klaus-liebler/whsplc01/pcb/V001/strapping.PNG

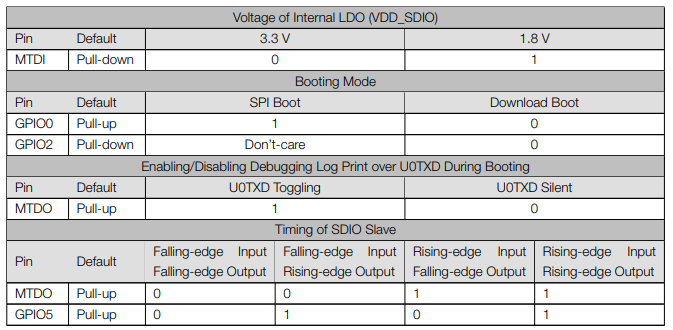
pcb/V001/strapping.PNG
