klaus-liebler/whsplc01/pcb/V001/V001.kicad_pcb

## KiCad design pcb/V001/V001.kicad_pcb (2020-04-13)

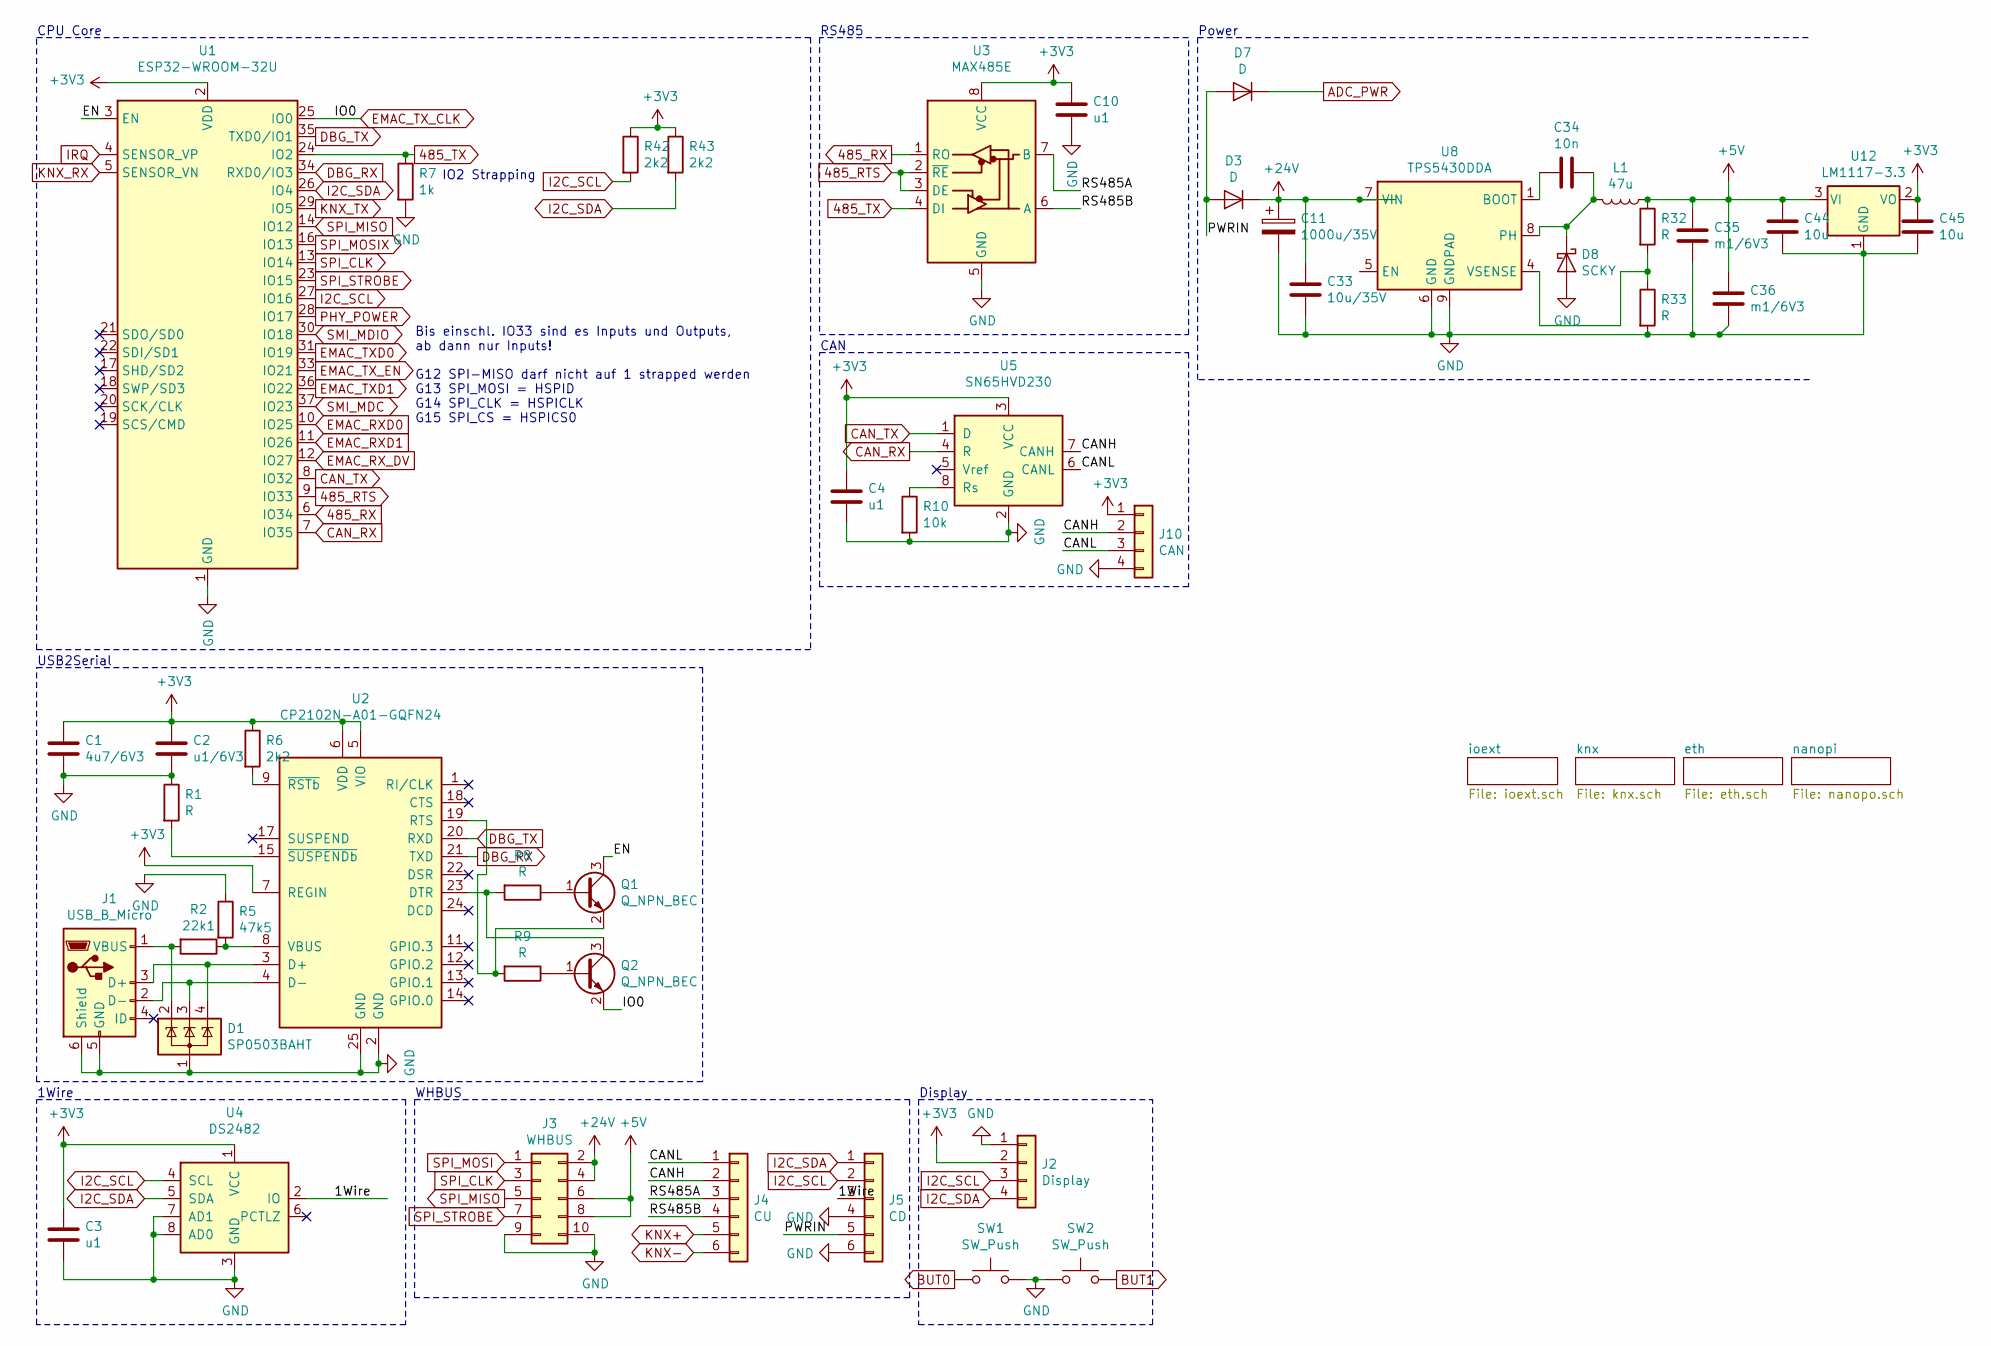
[picture p2: schematic V001.sch]

Parts:
C1: 4u7/6V3; C_0805_2012Metric
C2: u1/6V3; C_0603_1608Metric
C3, C4, C10: u1; C_0603_1608Metric
C11: 1000u/35V; CP_Radial_D10.0mm_P5.00mm_laydown
C33: 10u/35V; C_1210_3225Metric
C34: 10n; C_0603_1608Metric
C35, C36: m1/6V3; C_1206_3216Metric
C44, C45: 10u; C_0805_2012Metric
D1: SP0503BAHT; SOT-143
D3, D7: D; D_SOD-123
D8: SCKY; D_SMA
J1: USB_B_Micro; USB_Micro-B_Molex-105017-0001
J2: Display; PinHeader_1x04_P2.54mm_Vertical
J3: WHBUS; IDC-Header_2x05_P2.54mm_Vertical
J4: CU; Wago_734-136_1x06_P3.50mm_Vertical
J5: CD; Wago_734-136_1x06_P3.50mm_Vertical
J10: CAN; PinHeader_1x04_P2.54mm_Horizontal
L1: 47u; L_Wuerth_WE-PD-Typ-M-Typ-S_Handsoldering
Q1, Q2: Q_NPN_BEC; SOT-23
R1, R8, R9, R32, R33: R; R_0603_1608Metric
R2: 22k1; R_0603_1608Metric
R5: 47k5; R_0603_1608Metric
R6, R42, R43: 2k2; R_0603_1608Metric
R7: 1k; R_0603_1608Metric
R10: 10k; R_0603_1608Metric
SW1, SW2: SW_Push; SW_Tactile_SPST_Angled_PTS645Vx83-2LFS
U1: ESP32-WROOM-32U
U2: CP2102N-A01-GQFN24; QFN-24-1EP_4x4mm_P0.5mm_EP2.6x2.6mm
U3: MAX485E; SOIC-8_3.9x4.9mm_P1.27mm
U4: DS2482; SOIC-8_3.9x4.9mm_P1.27mm
U5: SN65HVD230; SOIC-8_3.9x4.9mm_P1.27mm
U8: TPS5430DDA; TI_SO-PowerPAD-8_ThermalVias
U12: LM1117-3.3; SOT-223-3_TabPin2

Connections:
485_RTS: U1.9 (IO33), U3.2 (~RE), U3.3 (DE)
485_RX: U1.6 (IO34), U3.1 (RO)
485_TX: R7.1, U1.24 (IO2), U3.4 (DI)
+3V3: C1.1, C2.1, C3.1, C4.1, C10.1, C45.1, J2.2, J10.1, R6.1, R42.1, R43.1, U1.2 (VDD), U2.5 (VIO), U2.6 (VDD), U2.7 (REGIN), U3.8 (VCC), U4.1 (VCC), U5.3 (VCC), U12.2 (VO); also elsewhere on the board
+5V: C35.1, C36.1, C44.1, J3.6, J3.8, L1.1, R32.1, U12.3 (VI); also elsewhere on the board
+24V: C11.1, C33.1, D3.1 (K), J3.2, J3.4, U8.7 (VIN)
/1Wire: J5.3, U4.2 (IO)
/CANH: J4.2, J10.2, U5.7 (CANH)
/CANL: J4.1, J10.3, U5.6 (CANL)
/EN: Q1.3 (C), U1.3 (EN)
/PWRIN: D3.2 (A), D7.2 (A), J5.5
/RS485A: J4.3, U3.7 (B)
/RS485B: J4.4, U3.6 (A)
ADC_PWR: D7.1 (K); also elsewhere on the board
BUT0: SW1.1; also elsewhere on the board
BUT1: SW2.2; also elsewhere on the board
CAN_RX: U1.7 (IO35), U5.4 (R)
CAN_TX: U1.8 (IO32), U5.1 (D)
DBG_RX: U1.34 (RXD0/IO3), U2.21 (TXD); also elsewhere on the board
DBG_TX: U1.35 (TXD0/IO1), U2.20 (RXD); also elsewhere on the board
EMAC_RXD0: U1.10 (IO25); also elsewhere on the board
EMAC_RXD1: U1.11 (IO26); also elsewhere on the board
EMAC_RX_DV: U1.12 (IO27); also elsewhere on the board
EMAC_TXD0: U1.31 (IO19); also elsewhere on the board
EMAC_TXD1: U1.36 (IO22); also elsewhere on the board
EMAC_TX_CLK: Q2.2 (E), U1.25 (IO0); also elsewhere on the board
EMAC_TX_EN: U1.33 (IO21); also elsewhere on the board
GND: C1.2, C2.2, C3.2, C4.2, C10.2, C11.2, C33.2, C35.2, C36.2, C44.2, C45.2, D1.1 (A), D8.2 (A), J1.5 (GND), J1.6 (Shield), J2.1, J3.9, J3.10, J5.4, J5.6, J10.4, R1.1, R5.1, R7.2, R10.2, R33.2, SW1.2, SW2.1, U1.1 (GND), U1.15 (GND), U1.38 (GND), U2.2 (GND), U2.25 (GND), U3.5 (GND), U4.3 (GND), U4.7 (AD1), U4.8 (AD0), U5.2 (GND), U8.6 (GND), U8.9 (GNDPAD), U12.1 (GND); also elsewhere on the board
I2C_SCL: J2.3, J5.2, R42.2, U1.27 (IO16), U4.4 (SCL)
I2C_SDA: J2.4, J5.1, R43.2, U1.26 (IO4), U4.5 (SDA)
KNX+: J4.5; also elsewhere on the board
KNX-: J4.6; also elsewhere on the board
KNX_RX: U1.5 (SENSOR_VN); also elsewhere on the board
KNX_TX: U1.29 (IO5); also elsewhere on the board
unnamed: C34.1, D8.1 (K), L1.2, U8.8 (PH)
unnamed: C34.2, U8.1 (BOOT)
unnamed: D1.2 (K), J1.1 (VBUS), R2.2
unnamed: D1.3 (K), J1.2 (D-), U2.4 (D-)
unnamed: D1.4 (K), J1.3 (D+), U2.3 (D+)
unnamed: Q1.1 (B), R8.1
unnamed: Q1.2 (E), R9.2, U2.19 (RTS)
unnamed: Q2.1 (B), R9.1
unnamed: Q2.3 (C), R8.2, U2.23 (DTR)
unnamed: R1.2, U2.15 (~SUSPENDb)
unnamed: R2.1, R5.2, U2.8 (VBUS)
unnamed: R6.2, U2.9 (~RSTb)
unnamed: R10.1, U5.8 (Rs)
unnamed: R32.2, R33.1, U8.4 (VSENSE)
PHY_POWER: U1.28 (IO17); also elsewhere on the board
SMI_MDC: U1.37 (IO23); also elsewhere on the board
SMI_MDIO: U1.30 (IO18); also elsewhere on the board
SPI_CLK: J3.3, U1.13 (IO14); also elsewhere on the board
SPI_MISO: J3.5, U1.14 (IO12)
SPI_MOSI: J3.1; also elsewhere on the board
SPI_MOSIX: U1.16 (IO13); also elsewhere on the board
SPI_STROBE: J3.7, U1.23 (IO15); also elsewhere on the board

Notes on the sheet:
G12 SPI-MISO darf nicht auf 1 strapped werden G13 SPI_MOSI = HSPID G14 SPI_CLK = HSPICLK G15 SPI_CS = HSPICS0
Bis einschl. IO33 sind es Inputs und Outputs, ab dann nur Inputs!
IO2 Strapping
CPU Core
USB2Serial
WHBUS
RS485
CAN
1Wire
Display
Power

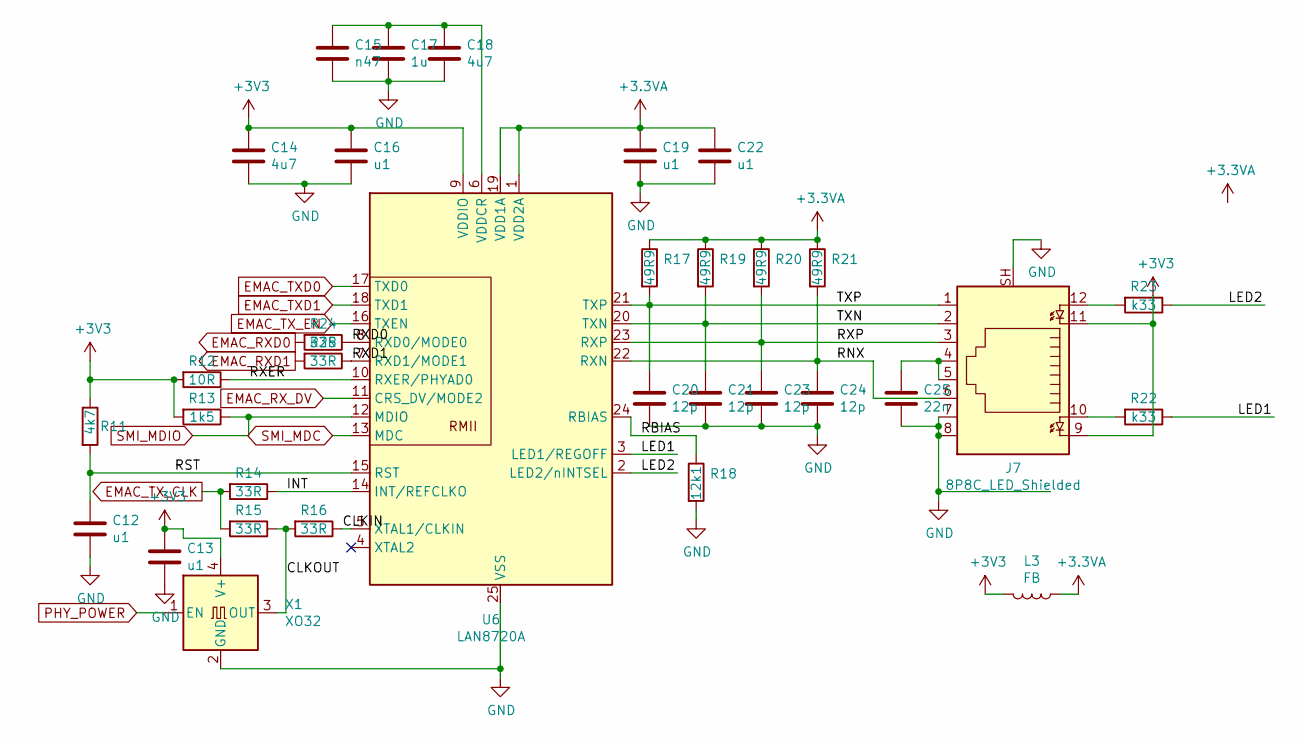
[picture p3: schematic eth.sch]

Parts:
C12, C13, C16, C19, C22: u1; C_0603_1608Metric
C14, C18: 4u7; C_0805_2012Metric
C15: n47; C_0603_1608Metric
C17: 1u; C_0805_2012Metric
C20, C21, C23, C24: 12p; C_0603_1608Metric
C25: 22n; C_0603_1608Metric
J7: 8P8C_LED_Shielded; RJ45_Hanrun_HR911105A
L3: FB; L_1206_3216Metric
R11: 4k7; R_0603_1608Metric
R12: 10R; R_0603_1608Metric
R13: 1k5; R_0603_1608Metric
R14, R15, R16, R24, R25: 33R; R_0603_1608Metric
R17, R19, R20, R21: 49R9; R_0603_1608Metric
R18: 12k1; R_0603_1608Metric
R22, R23: k33; R_0603_1608Metric
U6: LAN8720A; QFN-24-1EP_4x4mm_P0.5mm_EP2.6x2.6mm
X1: XO32; Oscillator_SMD_EuroQuartz_XO32-4Pin_3.2x2.5mm

Connections:
+3.3VA: C19.1, C22.1, L3.1, R17.1, R19.1, R20.1, R21.1, U6.1 (VDD2A), U6.19 (VDD1A)
+3V3: C13.1, C14.1, C16.1, J7.9, J7.11, L3.2, R11.1, R12.2, R13.2, U6.9 (VDDIO), X1.4 (V+); also elsewhere on the board
/eth/CLKIN: R16.1, U6.5 (XTAL1/CLKIN)
/eth/CLKOUT: R15.1, R16.2, X1.3 (OUT)
/eth/INT: R14.1, U6.14 (INT/REFCLKO)
/eth/LED1: R22.1, U6.3 (LED1/REGOFF)
/eth/LED2: R23.1, U6.2 (LED2/nINTSEL)
/eth/RBIAS: R18.1, U6.24 (RBIAS)
/eth/RNX: C24.1, J7.6, R21.2, U6.22 (RXN)
/eth/RST: C12.1, R11.2, U6.15 (RST)
/eth/RXD0: R24.1, U6.8 (RXD0/MODE0)
/eth/RXD1: R25.1, U6.7 (RXD1/MODE1)
/eth/RXER: R12.1, U6.10 (RXER/PHYAD0)
/eth/RXP: C23.1, J7.3, R20.2, U6.23 (RXP)
/eth/TXN: C21.1, J7.2, R19.2, U6.20 (TXN)
/eth/TXP: C20.1, J7.1, R17.2, U6.21 (TXP)
EMAC_RXD0: R24.2; also elsewhere on the board
EMAC_RXD1: R25.2; also elsewhere on the board
EMAC_RX_DV: U6.11 (CRS_DV/MODE2); also elsewhere on the board
EMAC_TXD0: U6.17 (TXD0); also elsewhere on the board
EMAC_TXD1: U6.18 (TXD1); also elsewhere on the board
EMAC_TX_CLK: R14.2, R15.2; also elsewhere on the board
EMAC_TX_EN: U6.16 (TXEN); also elsewhere on the board
GND: C12.2, C13.2, C14.2, C15.2, C16.2, C17.2, C18.2, C19.2, C20.2, C21.2, C22.2, C23.2, C24.2, C25.2, J7.7, J7.8, J7.SH, R18.2, U6.25 (VSS), X1.2 (GND); also elsewhere on the board
unnamed: C15.1, C17.1, C18.1, U6.6 (VDDCR)
unnamed: C25.1, J7.4, J7.5
unnamed: J7.10, R22.2
unnamed: J7.12, R23.2
PHY_POWER: X1.1 (EN); also elsewhere on the board
SMI_MDC: U6.13 (MDC); also elsewhere on the board
SMI_MDIO: R13.1, U6.12 (MDIO); also elsewhere on the board

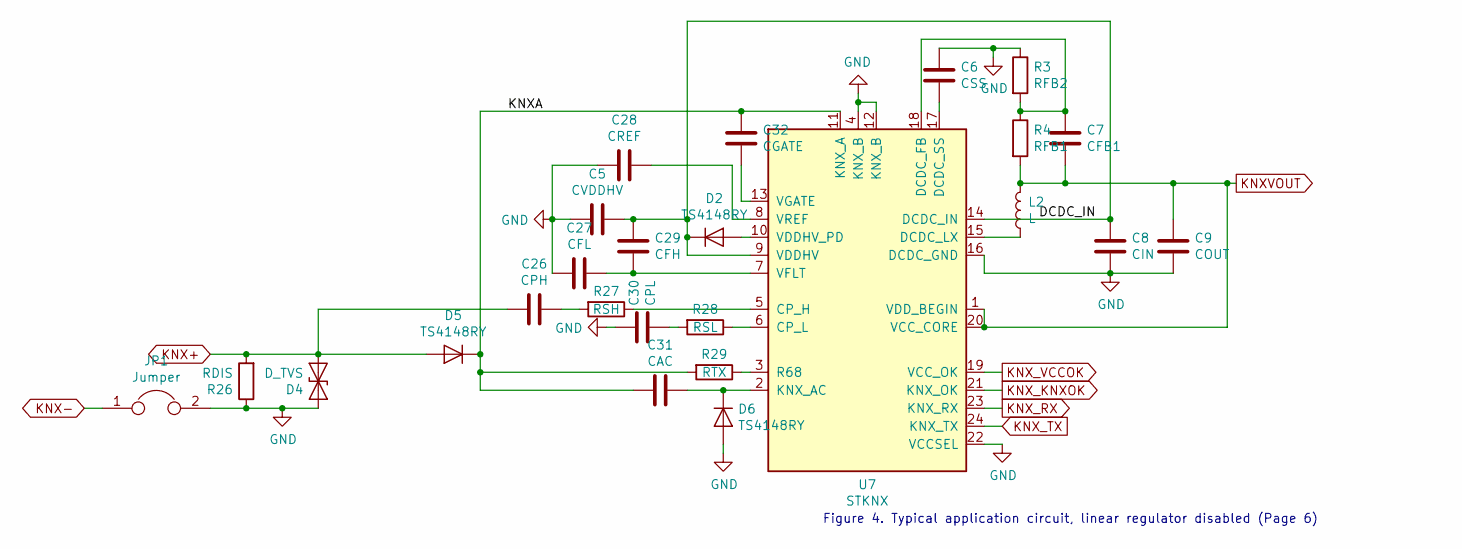
[picture p4: schematic knx.sch]

Parts:
C5: CVDDHV; C_0603_1608Metric
C6: CSS; C_0603_1608Metric
C7: CFB1; C_0603_1608Metric
C8: CIN; C_1206_3216Metric
C9: COUT; C_1206_3216Metric
C26: CPH; C_0603_1608Metric
C27: CFL; C_0603_1608Metric
C28: CREF; C_0603_1608Metric
C29: CFH; C_0603_1608Metric
C30: CPL; C_0603_1608Metric
C31: CAC; C_0603_1608Metric
C32: CGATE; C_0603_1608Metric
D2, D5, D6: TS4148RY; D_0805_2012Metric
D4: D_TVS; D_SMC
JP1: Jumper; SolderJumper-2_P1.3mm_Open_Pad1.0x1.5mm
L2: L; L_Wuerth_HCI-5040
R3: RFB2; R_0603_1608Metric
R4: RFB1; R_0603_1608Metric
R26: RDIS; R_0603_1608Metric
R27: RSH; R_0603_1608Metric
R28: RSL; R_0603_1608Metric
R29: RTX; R_2512_6332Metric
U7: STKNX; VQFN-24-1EP_4x4mm_P0.5mm_EP2.45x2.45mm_ThermalVias

Connections:
/knx/DCDC_IN: C5.1, C8.1, C29.1, D2.1 (K), U7.9 (VDDHV), U7.14 (DCDC_IN)
GND: C5.2, C6.1, C8.2, C9.2, C27.2, C28.2, C30.1, D4.1 (A1), D6.2 (A), JP1.2, R3.1, R26.1, U7.4 (KNX_B), U7.12 (KNX_B), U7.16 (DCDC_GND), U7.22 (VCCSEL); also elsewhere on the board
KNX+: C26.2, D4.2 (A2), D5.2 (A), R26.2; also elsewhere on the board
KNX-: JP1.1; also elsewhere on the board
KNXVOUT: C7.2, C9.1, L2.2, R4.2, U7.1 (VDD_BEGIN), U7.20 (VCC_CORE)
KNX_RX: U7.23 (KNX_RX); also elsewhere on the board
KNX_TX: U7.24 (KNX_TX); also elsewhere on the board
unnamed: C6.2, U7.17 (DCDC_SS)
unnamed: C7.1, R3.2, R4.1, U7.18 (DCDC_FB)
unnamed: C26.1, R27.2
unnamed: C27.1, C29.2, U7.7 (VFLT)
unnamed: C28.1, U7.8 (VREF)
unnamed: C30.2, R28.2
unnamed: C31.1, D6.1 (K), U7.2 (KNX_AC)
unnamed: C31.2, C32.2, D5.1 (K), R29.2, U7.11 (KNX_A)
unnamed: C32.1, U7.13 (VGATE)
unnamed: D2.2 (A), U7.10 (VDDHV_PD)
unnamed: L2.1, U7.15 (DCDC_LX)
unnamed: R27.1, U7.5 (CP_H)
unnamed: R28.1, U7.6 (CP_L)
unnamed: R29.1, U7.3 (R68)

Notes on the sheet:
Figure 4. Typical application circuit, linear regulator disabled (Page 6)

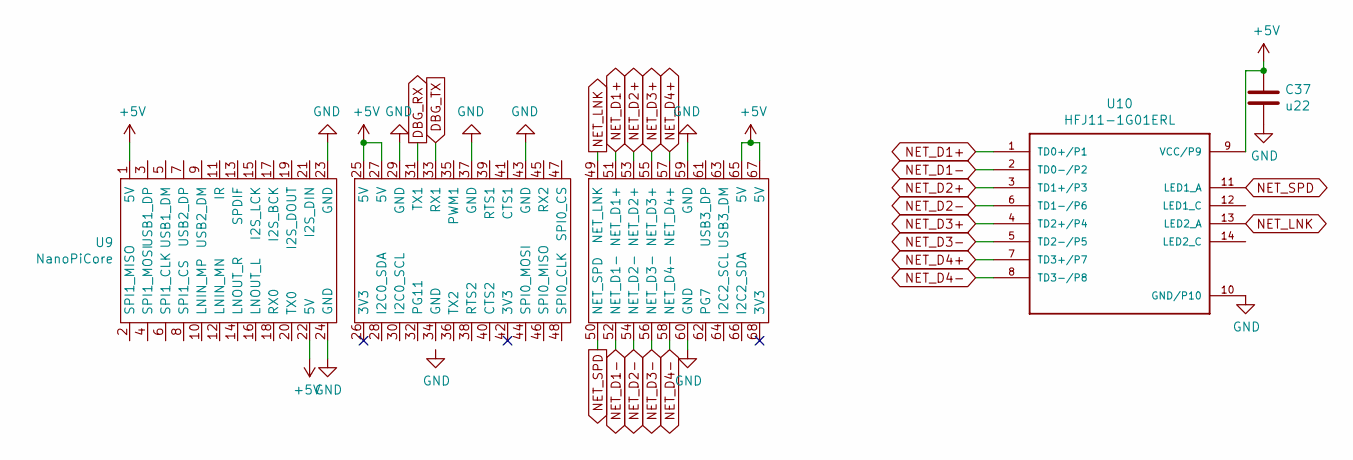
[picture p5: schematic nanopo.sch]

Parts:
C37: u22; C_0603_1608Metric
U9: NanoPiCore; NanoPi NEO Core2
U10: HFJ11-1G01ERL; HALO_HFJ11-1G01ERL

Connections:
+5V: C37.1, U9.1 (5V), U9.22 (5V), U9.25 (5V), U9.27 (5V), U9.65 (5V), U9.67 (5V), U10.9 (VCC/P9); also elsewhere on the board
DBG_RX: U9.31 (TX1); also elsewhere on the board
DBG_TX: U9.33 (RX1); also elsewhere on the board
GND: C37.2, U9.23 (GND), U9.24 (GND), U9.29 (GND), U9.37 (GND), U9.43 (GND), U9.59 (GND), U9.60 (GND), U10.10 (GND/P10); also elsewhere on the board
NET_D1+: U9.51 (NET_D1+), U10.1 (TD0+/P1)
NET_D1-: U9.52 (NET_D1-), U10.2 (TD0-/P2)
NET_D2+: U9.53 (NET_D2+), U10.3 (TD1+/P3)
NET_D2-: U9.54 (NET_D2-), U10.6 (TD1-/P6)
NET_D3+: U9.55 (NET_D3+), U10.4 (TD2+/P4)
NET_D3-: U9.56 (NET_D3-), U10.5 (TD2-/P5)
NET_D4+: U9.57 (NET_D4+), U10.7 (TD3+/P7)
NET_D4-: U9.58 (NET_D4-), U10.8 (TD3-/P8)
NET_LNK: U9.49 (NET_LNK), U10.13 (LED2_A)
NET_SPD: U9.50 (NET_SPD), U10.11 (LED1_A)

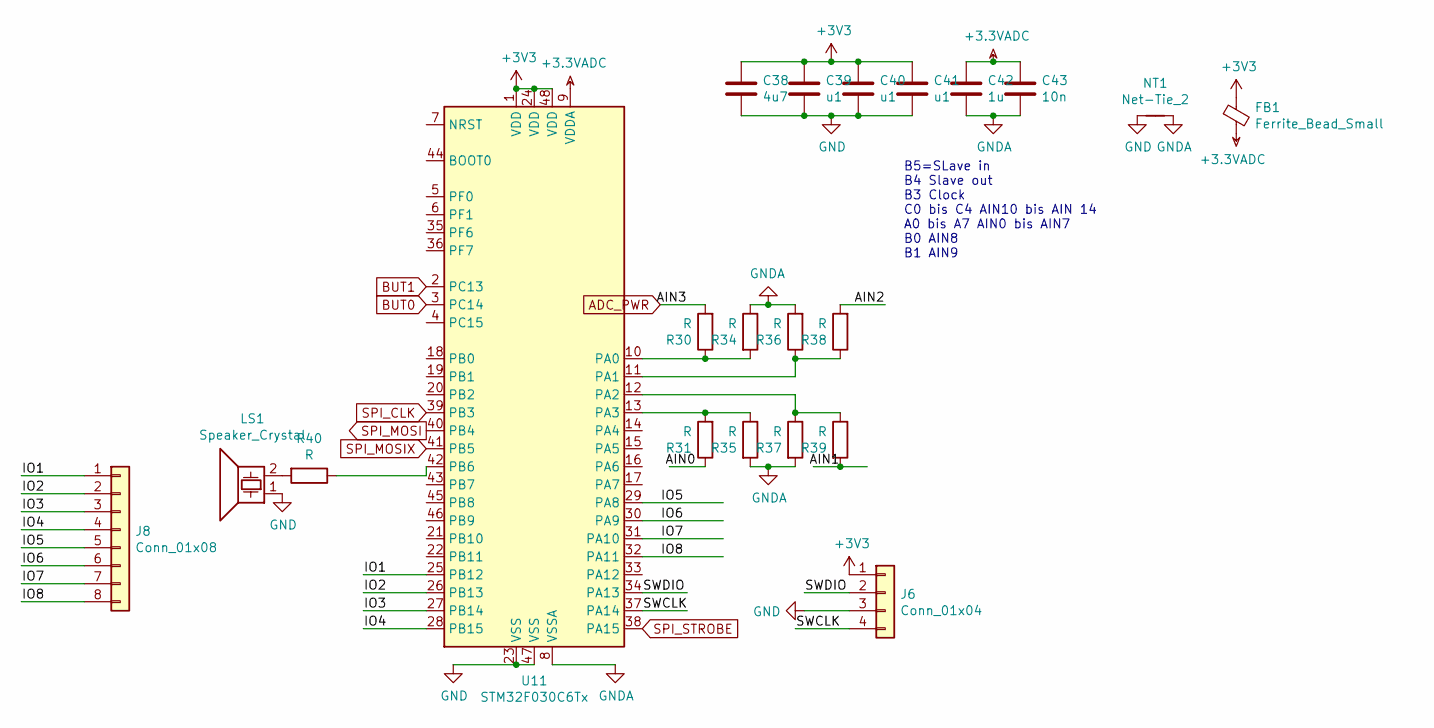
[picture p6: schematic ioext.sch]

Parts:
C38: 4u7; C_0805_2012Metric
C39, C40, C41: u1; C_0603_1608Metric
C42: 1u; C_0603_1608Metric
C43: 10n; C_0603_1608Metric
FB1: Ferrite_Bead_Small; L_1206_3216Metric
J6: Conn_01x04; Tag-Connect_TC2030-IDC-NL_2x03_P1.27mm_Vertical
J8: Conn_01x08; PinHeader_1x08_P2.54mm_Vertical
LS1: Speaker_Crystal; Buzzer_12x9.5RM7.6
NT1: Net-Tie_2; NetTie-2_SMD_Pad0.5mm
R30, R31, R34, R35, R36, R37, R38, R39, R40: R; R_0603_1608Metric
U11: STM32F030C6Tx; LQFP-48_7x7mm_P0.5mm

Connections:
+3.3VADC: C42.1, C43.1, FB1.2, U11.9 (VDDA)
+3V3: C38.1, C39.1, C40.1, C41.1, FB1.1, J6.1, U11.1 (VDD), U11.24 (VDD), U11.48 (VDD); also elsewhere on the board
/ioext/IO1: J8.1, U11.25 (PB12)
/ioext/IO2: J8.2, U11.26 (PB13)
/ioext/IO3: J8.3, U11.27 (PB14)
/ioext/IO4: J8.4, U11.28 (PB15)
/ioext/IO5: J8.5, U11.29 (PA8)
/ioext/IO6: J8.6, U11.30 (PA9)
/ioext/IO7: J8.7, U11.31 (PA10)
/ioext/IO8: J8.8, U11.32 (PA11)
/ioext/SWCLK: J6.4, U11.37 (PA14)
/ioext/SWDIO: J6.2, U11.34 (PA13)
ADC_PWR: R30.2; also elsewhere on the board
BUT0: U11.3 (PC14); also elsewhere on the board
BUT1: U11.2 (PC13); also elsewhere on the board
GND: C38.2, C39.2, C40.2, C41.2, J6.3, LS1.1, NT1.1, U11.23 (VSS), U11.47 (VSS); also elsewhere on the board
GNDA: C42.2, C43.2, NT1.2, R34.1, R35.2, R36.2, R37.2, U11.8 (VSSA)
unnamed: LS1.2, R40.2
unnamed: R30.1, R34.2, U11.10 (PA0)
unnamed: R31.2, R35.1, U11.13 (PA3)
unnamed: R36.1, R38.1, U11.11 (PA1)
unnamed: R37.1, R39.1, U11.12 (PA2)
unnamed: R40.1, U11.42 (PB6)
SPI_CLK: U11.39 (PB3); also elsewhere on the board
SPI_MOSI: U11.40 (PB4); also elsewhere on the board
SPI_MOSIX: U11.41 (PB5); also elsewhere on the board
SPI_STROBE: U11.38 (PA15); also elsewhere on the board

Notes on the sheet:
B5=SLave in B4 Slave out B3 Clock C0 bis C4 AIN10 bis AIN 14 A0 bis A7 AIN0 bis AIN7 B0 AIN8 B1 AIN9

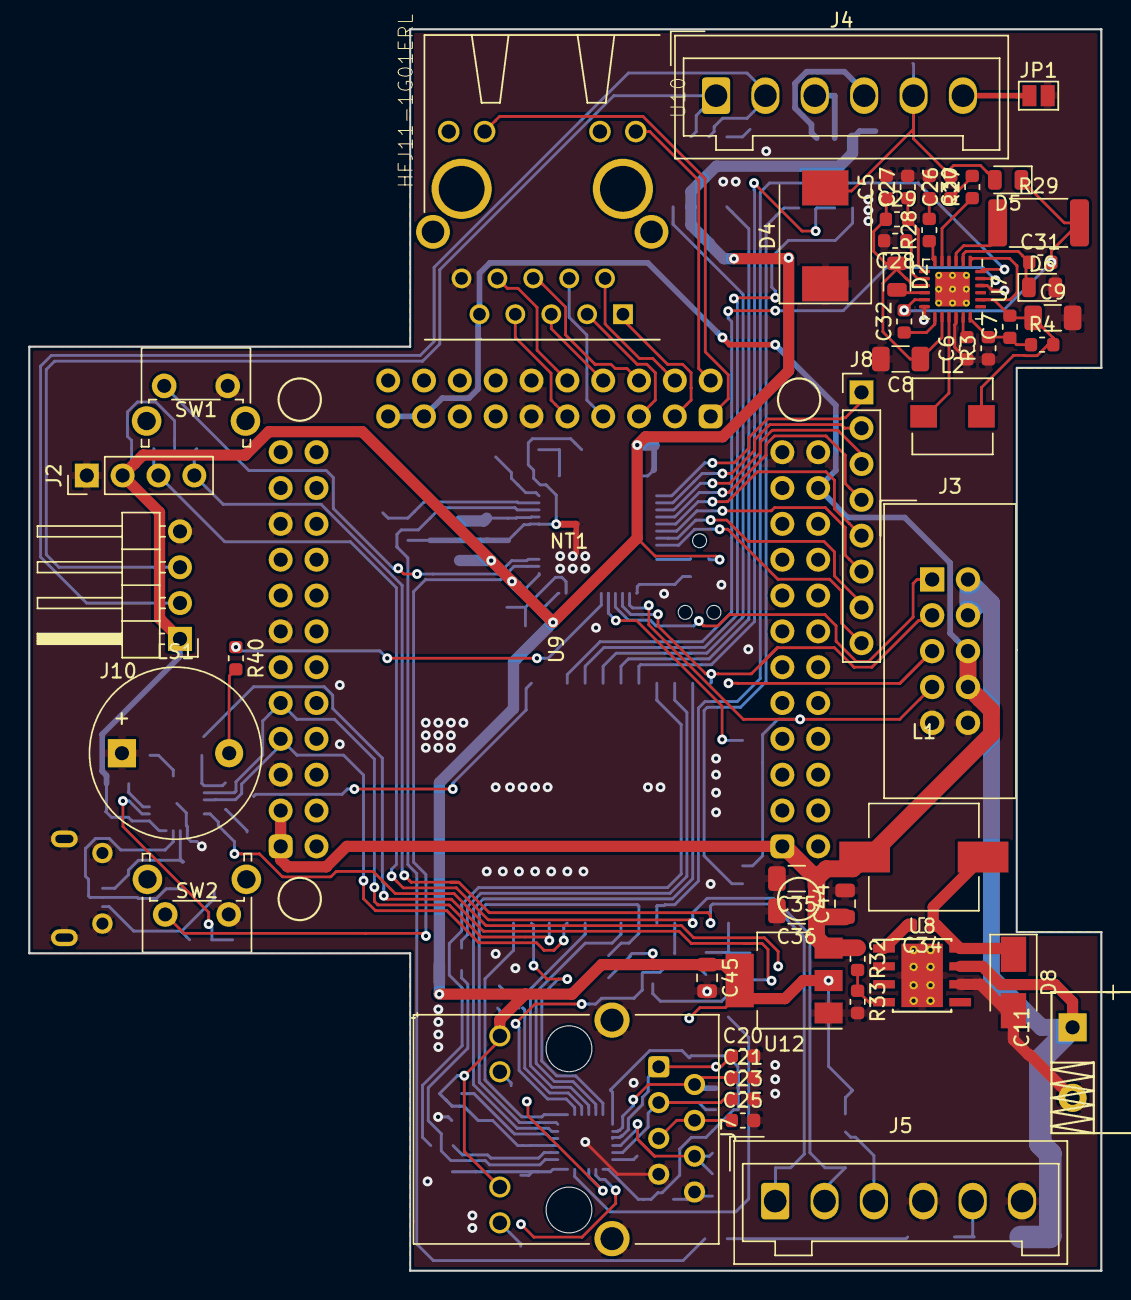
[picture p7: board V001.kicad_pcb from above]

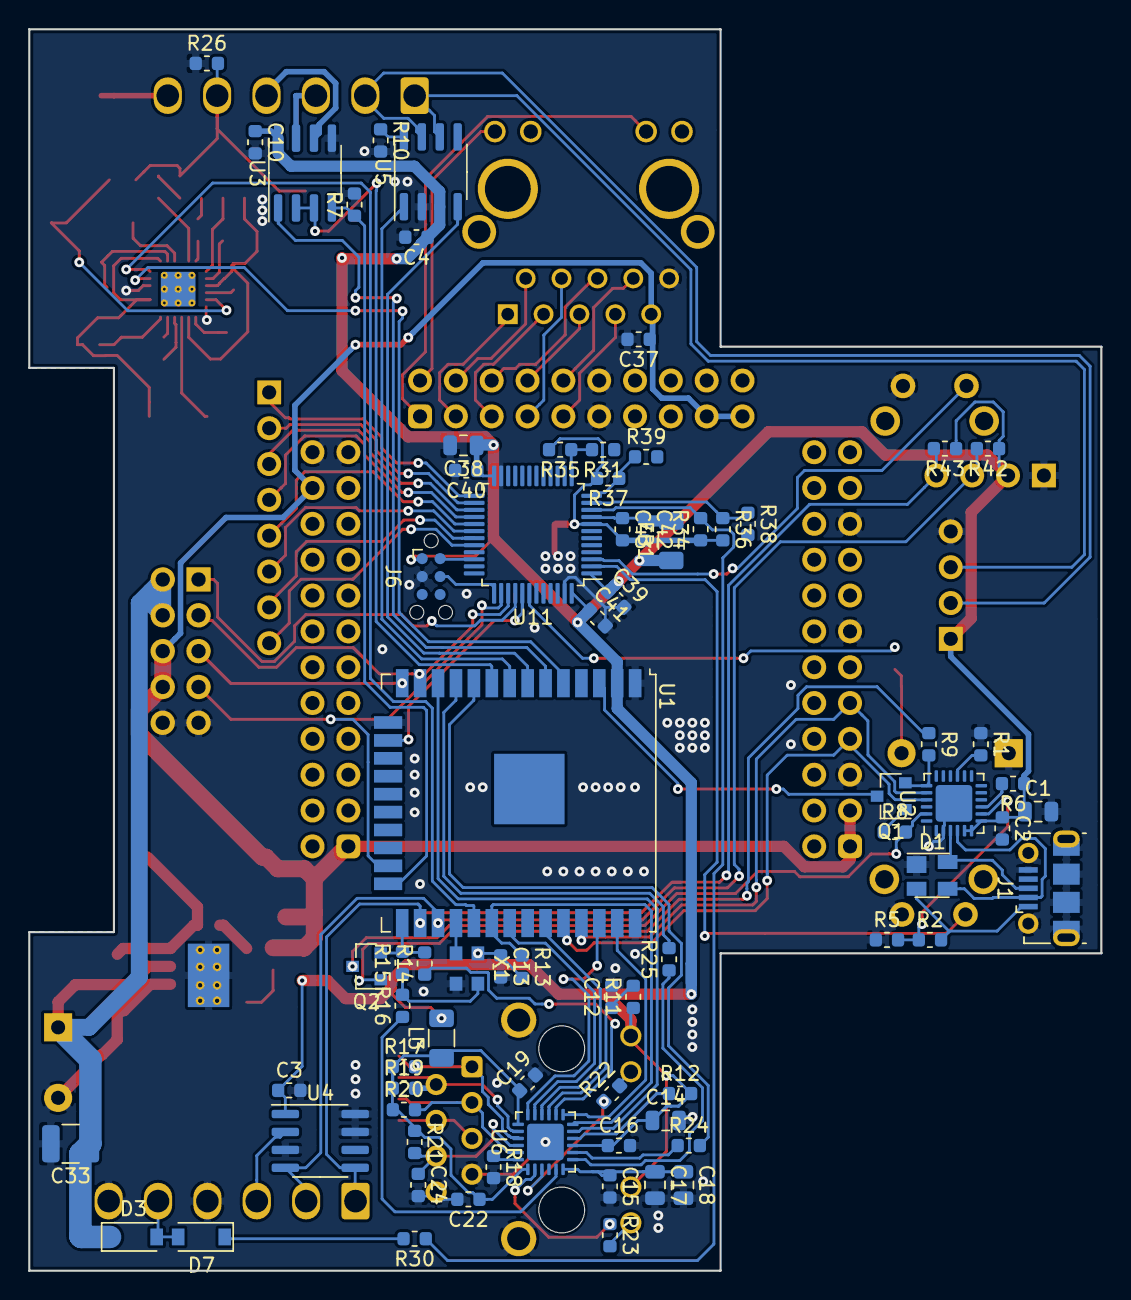
[picture p8: board V001.kicad_pcb from below]

Board: 2 copper layers, 76.0 x 88.0 mm, 128 parts (74 on the bottom side), 119 nets.
